sirvan3tr/axon/OpenBCI_ESP32_BASE/OpenBCI_ESP32_BASE.JPG

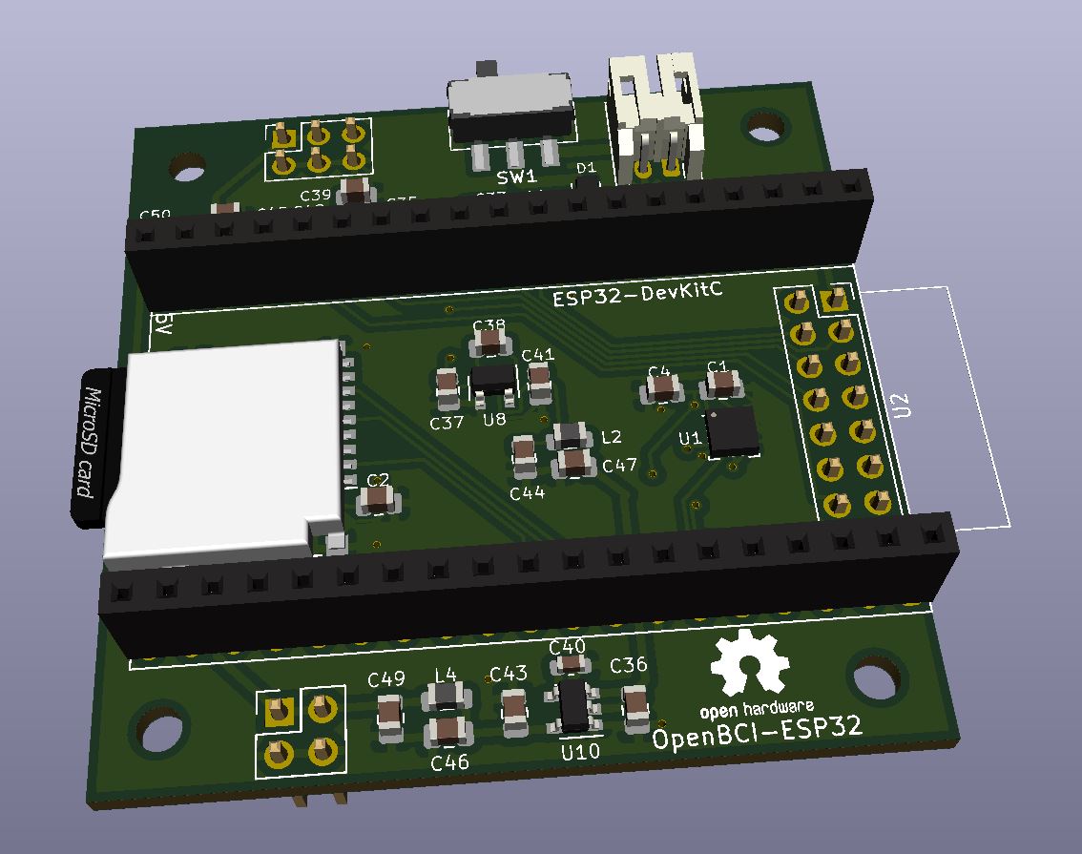
OpenBCI_ESP32_BASE/OpenBCI_ESP32_BASE.JPG
