sirvan3tr/axon/OpenBCI_ESP32_BASE/esp32-devkitc.jpg

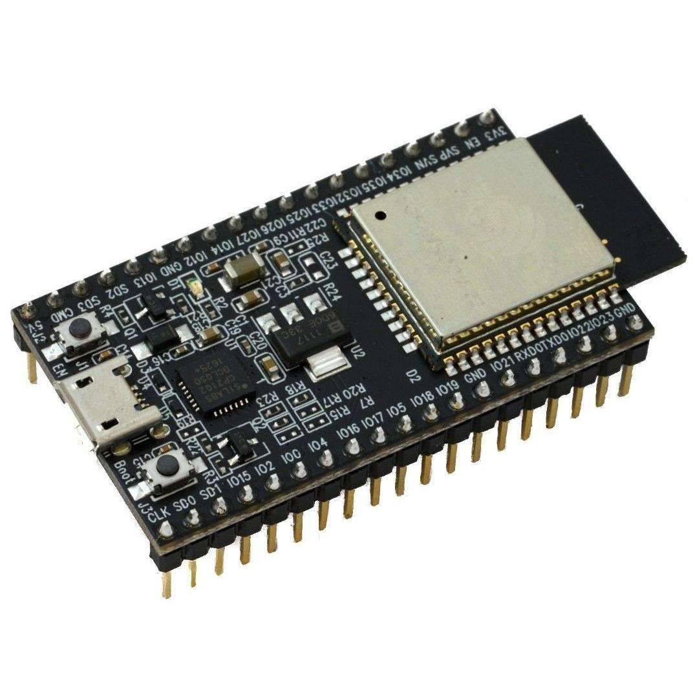
OpenBCI_ESP32_BASE/esp32-devkitc.jpg
