sirvan3tr/axon/README.md

# AXON Firmware

This repo contains the necessary source code to operate the AXON (OpenBCI_ESP32) board.

* **ADS1299**.  This is the 24bit ADC. Has its own independent header file.
* **LIS3DH**.  Accelerator.
* **Board**.  Wrapper class to manage all the other classes.
* **Daisy**.  TBC.
