sirvan3tr/axon/docs.md

# Documentation

* Read the [Arduino Notebook](http://engineering.nyu.edu/gk12/amps-cbri/pdf/ArduinoBooks/Arduino%20Programming%20Notebook.pdf) for more information on types when programming arduino.
* `pinMode()` is an Arduino function. *"Configures the specified pin to behave either as an input or an output. See the Digital Pins page for details on the functionality of the pins."*
* Following [Qt Coding Style](https://wiki.qt.io/Qt_Coding_Style).
* Using [Doxygen](https://www.doxygen.nl/manual/docblocks.html#specialblock) to document the code.
