sirvan3tr/axon/OpenBCI_ESP32_INPUT/OpenBCI_ESP32_INPUT.JPG

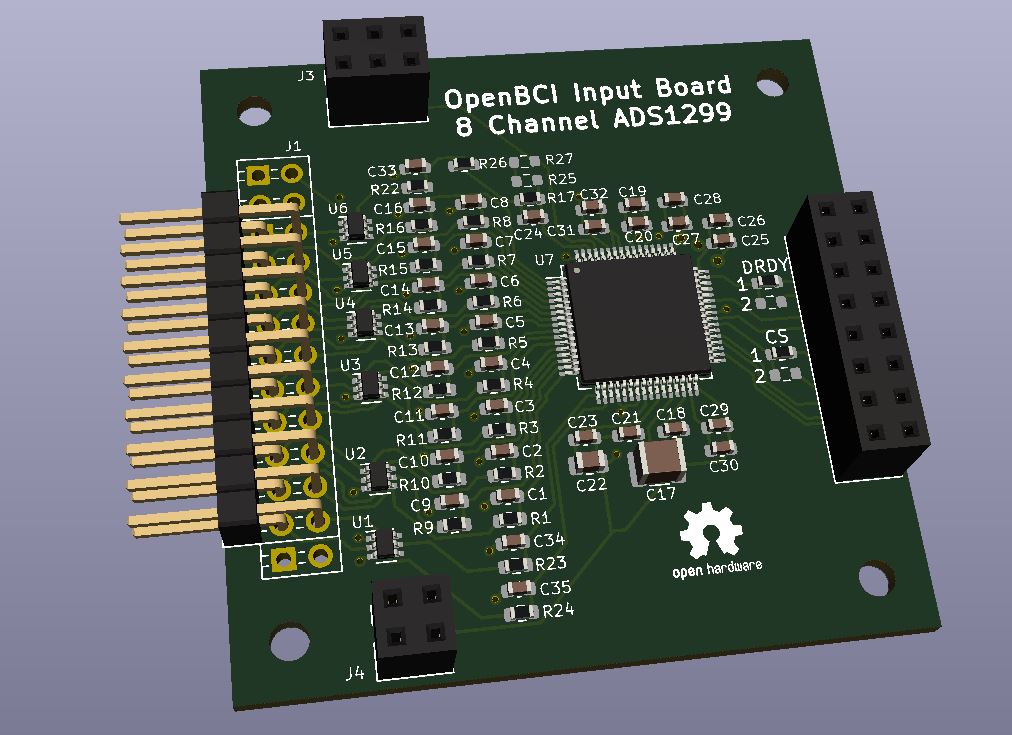
OpenBCI_ESP32_INPUT/OpenBCI_ESP32_INPUT.JPG
