sirvan3tr/axon/Case/Battery.stl

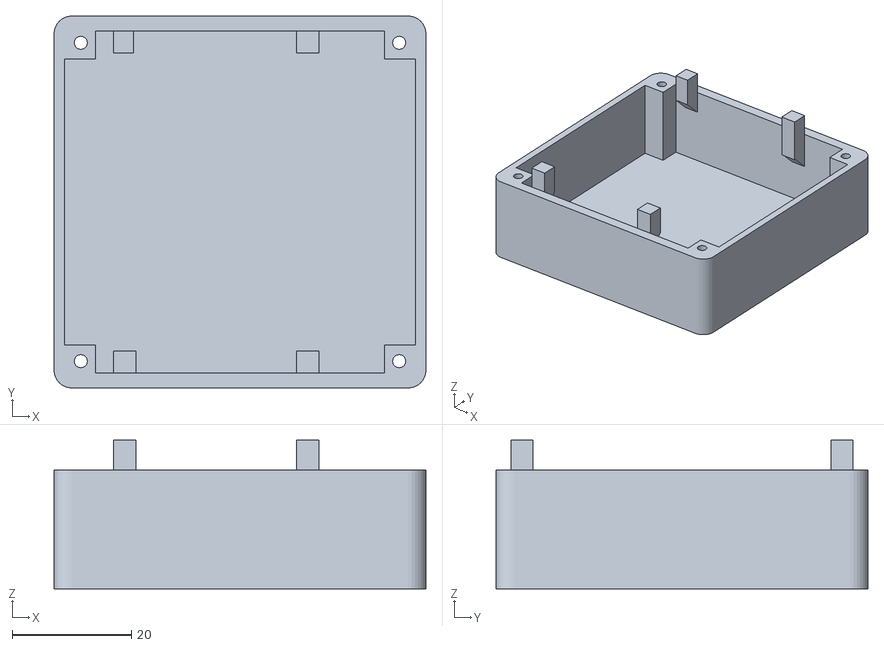
[picture p4: CAD file, 2022-03-14]
Case/Battery.stl
62.5 x 62.5 x 25.0
