sirvan3tr/axon/Case/Switch.stl

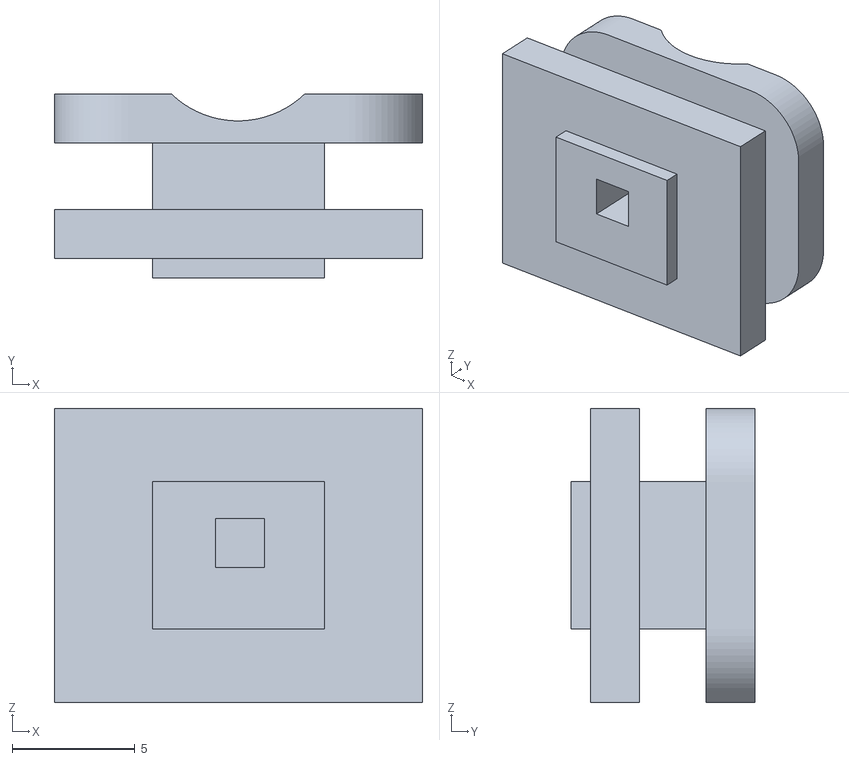
[picture p5: CAD file, 2022-03-14]
Case/Switch.stl
15.0 x 7.50 x 12.0
