sirvan3tr/axon/Case/Input_8.stl

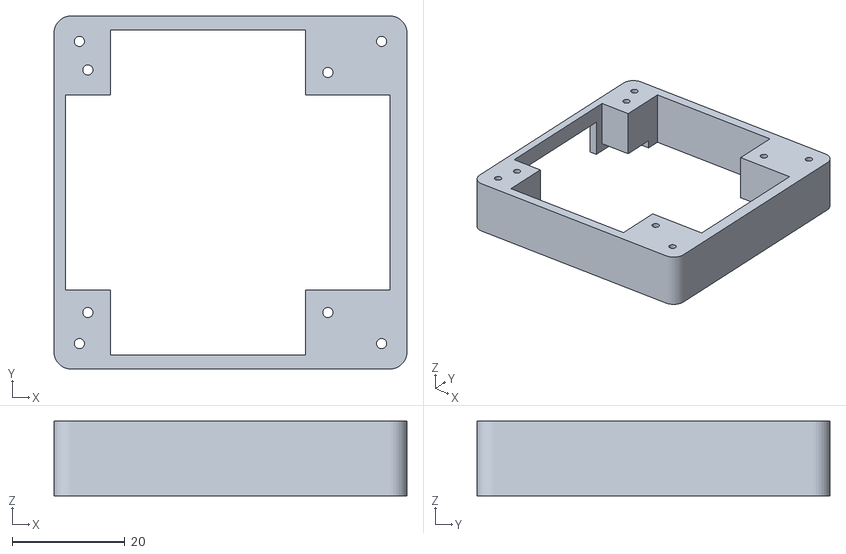
[picture p6: CAD file, 2022-03-14]
Case/Input_8.stl
62.5 x 62.5 x 13.2
