sirvan3tr/axon/Case/Base.stl

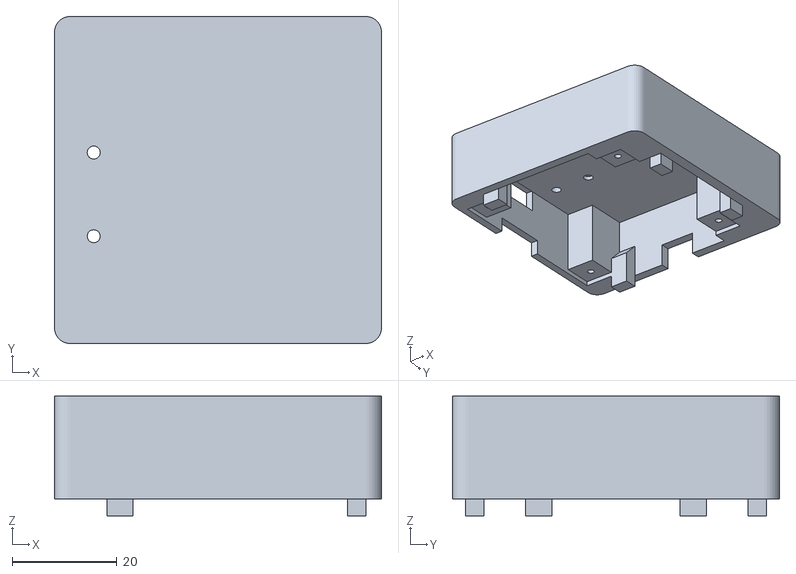
[picture p7: CAD file, 2022-03-14]
Case/Base.stl
62.5 x 62.5 x 22.9
