sirvan3tr/axon/OpenBCI_ESP32_BASE/JS102011SAQN.STEP

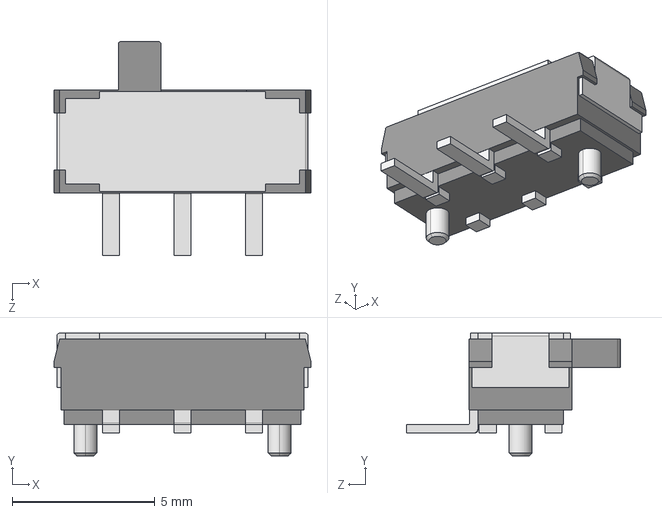
[picture p8: CAD file, 2022-03-14]
OpenBCI_ESP32_BASE/JS102011SAQN.STEP
9.00 x 4.30 x 7.50 mm
