sirvan3tr/axon/(list of files, cad)

Other CAD files:
Case/OpenBCI_ESP v18.f3d
