sirvan3tr/axon/OpenBCI_ESP32_INPUT/OpenBCI_ESP32_INPUT.kicad_pcb

## KiCad design OpenBCI_ESP32_INPUT/OpenBCI_ESP32_INPUT.kicad_pcb (2022-03-14)

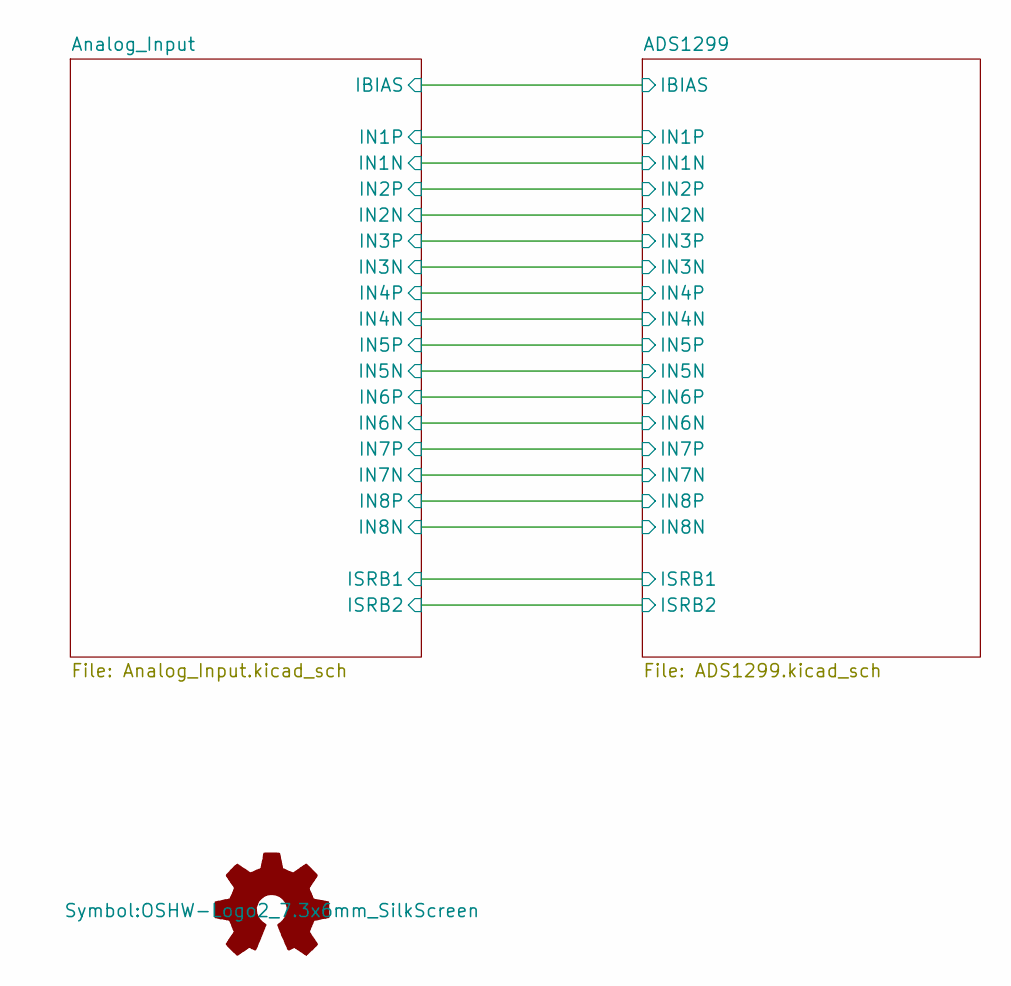
[picture p13: schematic OpenBCI_ESP32_INPUT.kicad_sch]

Parts:
LOGO1: Logo_Open_Hardware_Small; OSHW-Logo2_7.3x6mm_SilkScreen

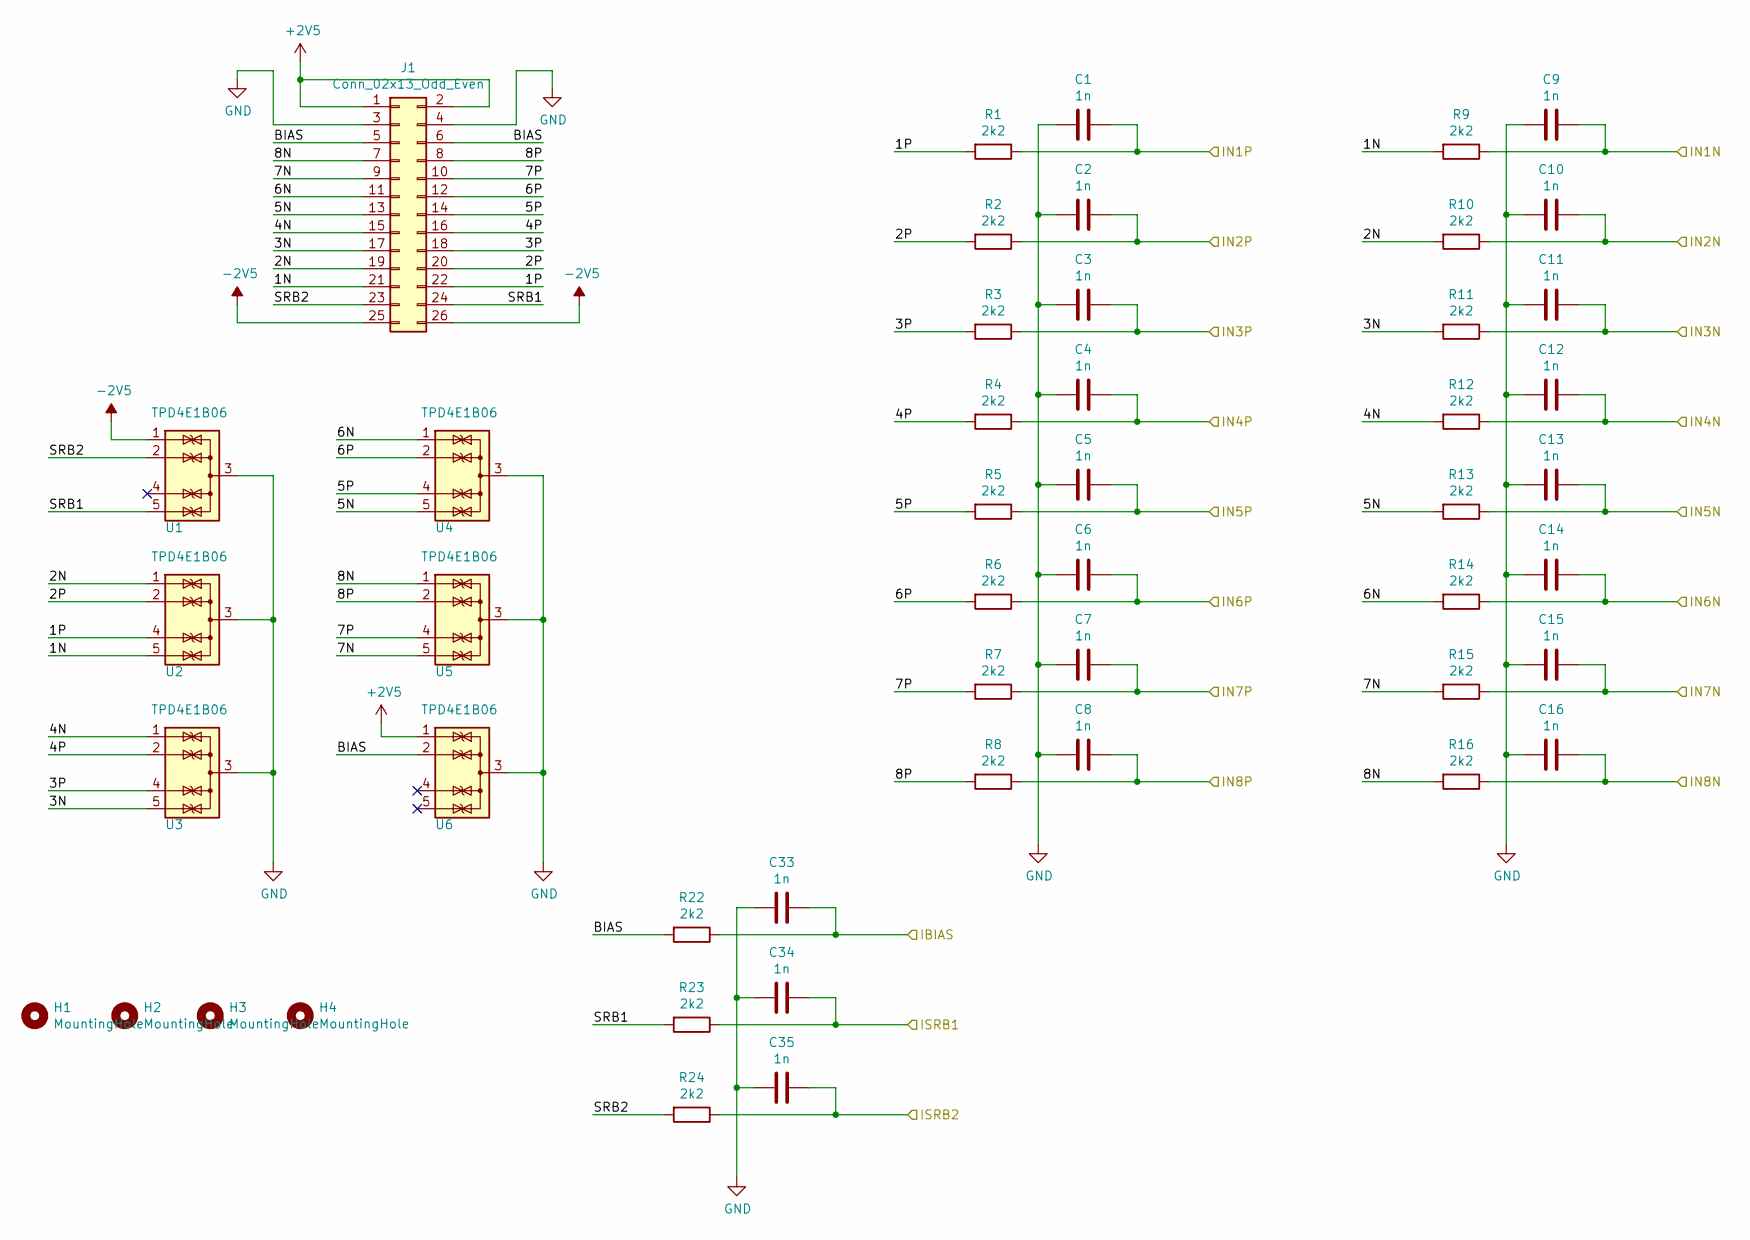
[picture p14: schematic Analog_Input.kicad_sch]

Parts:
C1, C2, C3, C4, C5, C6, C7, C8, C9, C10, C11, C12, C13, C14, C15, C16, C33, C34, C35: 1n; C_0603_1608Metric
H1, H2, H3, H4: MountingHole; MountingHole_2.7mm_M2.5
J1: Conn_02x13_Odd_Even; PinHeader_2x13_P2.54mm_OpenBCI
R1, R2, R3, R4, R5, R6, R7, R8, R9, R10, R11, R12, R13, R14, R15, R16, R22, R23, R24: 2k2; R_0603_1608Metric
U1, U2, U3, U4, U5, U6: TPD4E1B06; SOT-363_SC-70-6

Connections:
+2V5: J1.1, J1.2, U6.1 (IO1); also elsewhere on the board
-2V5: J1.25, J1.26, U1.1 (IO1); also elsewhere on the board
/ADS1299/IBIAS: C33.1, R22.1; also elsewhere on the board
/ADS1299/IN1N: C9.1, R9.1; also elsewhere on the board
/ADS1299/IN1P: C1.1, R1.1; also elsewhere on the board
/ADS1299/IN2N: C10.1, R10.1; also elsewhere on the board
/ADS1299/IN2P: C2.1, R2.1; also elsewhere on the board
/ADS1299/IN3N: C11.1, R11.1; also elsewhere on the board
/ADS1299/IN3P: C3.1, R3.1; also elsewhere on the board
/ADS1299/IN4N: C12.1, R12.1; also elsewhere on the board
/ADS1299/IN4P: C4.1, R4.1; also elsewhere on the board
/ADS1299/IN5N: C13.1, R13.1; also elsewhere on the board
/ADS1299/IN5P: C5.1, R5.1; also elsewhere on the board
/ADS1299/IN6N: C14.1, R14.1; also elsewhere on the board
/ADS1299/IN6P: C6.1, R6.1; also elsewhere on the board
/ADS1299/IN7N: C15.1, R15.1; also elsewhere on the board
/ADS1299/IN7P: C7.1, R7.1; also elsewhere on the board
/ADS1299/IN8N: C16.1, R16.1; also elsewhere on the board
/ADS1299/IN8P: C8.1, R8.1; also elsewhere on the board
/ADS1299/ISRB1: C34.1, R23.1; also elsewhere on the board
/ADS1299/ISRB2: C35.1, R24.1; also elsewhere on the board
/Analog_Input/1N: J1.21, R9.2, U2.5 (IO4)
/Analog_Input/1P: J1.22, R1.2, U2.4 (IO3)
/Analog_Input/2N: J1.19, R10.2, U2.1 (IO1)
/Analog_Input/2P: J1.20, R2.2, U2.2 (IO2)
/Analog_Input/3N: J1.17, R11.2, U3.5 (IO4)
/Analog_Input/3P: J1.18, R3.2, U3.4 (IO3)
/Analog_Input/4N: J1.15, R12.2, U3.1 (IO1)
/Analog_Input/4P: J1.16, R4.2, U3.2 (IO2)
/Analog_Input/5N: J1.13, R13.2, U4.5 (IO4)
/Analog_Input/5P: J1.14, R5.2, U4.4 (IO3)
/Analog_Input/6N: J1.11, R14.2, U4.1 (IO1)
/Analog_Input/6P: J1.12, R6.2, U4.2 (IO2)
/Analog_Input/7N: J1.9, R15.2, U5.5 (IO4)
/Analog_Input/7P: J1.10, R7.2, U5.4 (IO3)
/Analog_Input/8N: J1.7, R16.2, U5.1 (IO1)
/Analog_Input/8P: J1.8, R8.2, U5.2 (IO2)
/Analog_Input/BIAS: J1.5, J1.6, R22.2, U6.2 (IO2)
/Analog_Input/SRB1: J1.24, R23.2, U1.5 (IO4)
/Analog_Input/SRB2: J1.23, R24.2, U1.2 (IO2)
GND: C1.2, C2.2, C3.2, C4.2, C5.2, C6.2, C7.2, C8.2, C9.2, C10.2, C11.2, C12.2, C13.2, C14.2, C15.2, C16.2, C33.2, C34.2, C35.2, J1.3, J1.4, U1.3 (G), U2.3 (G), U3.3 (G), U4.3 (G), U5.3 (G), U6.3 (G); also elsewhere on the board

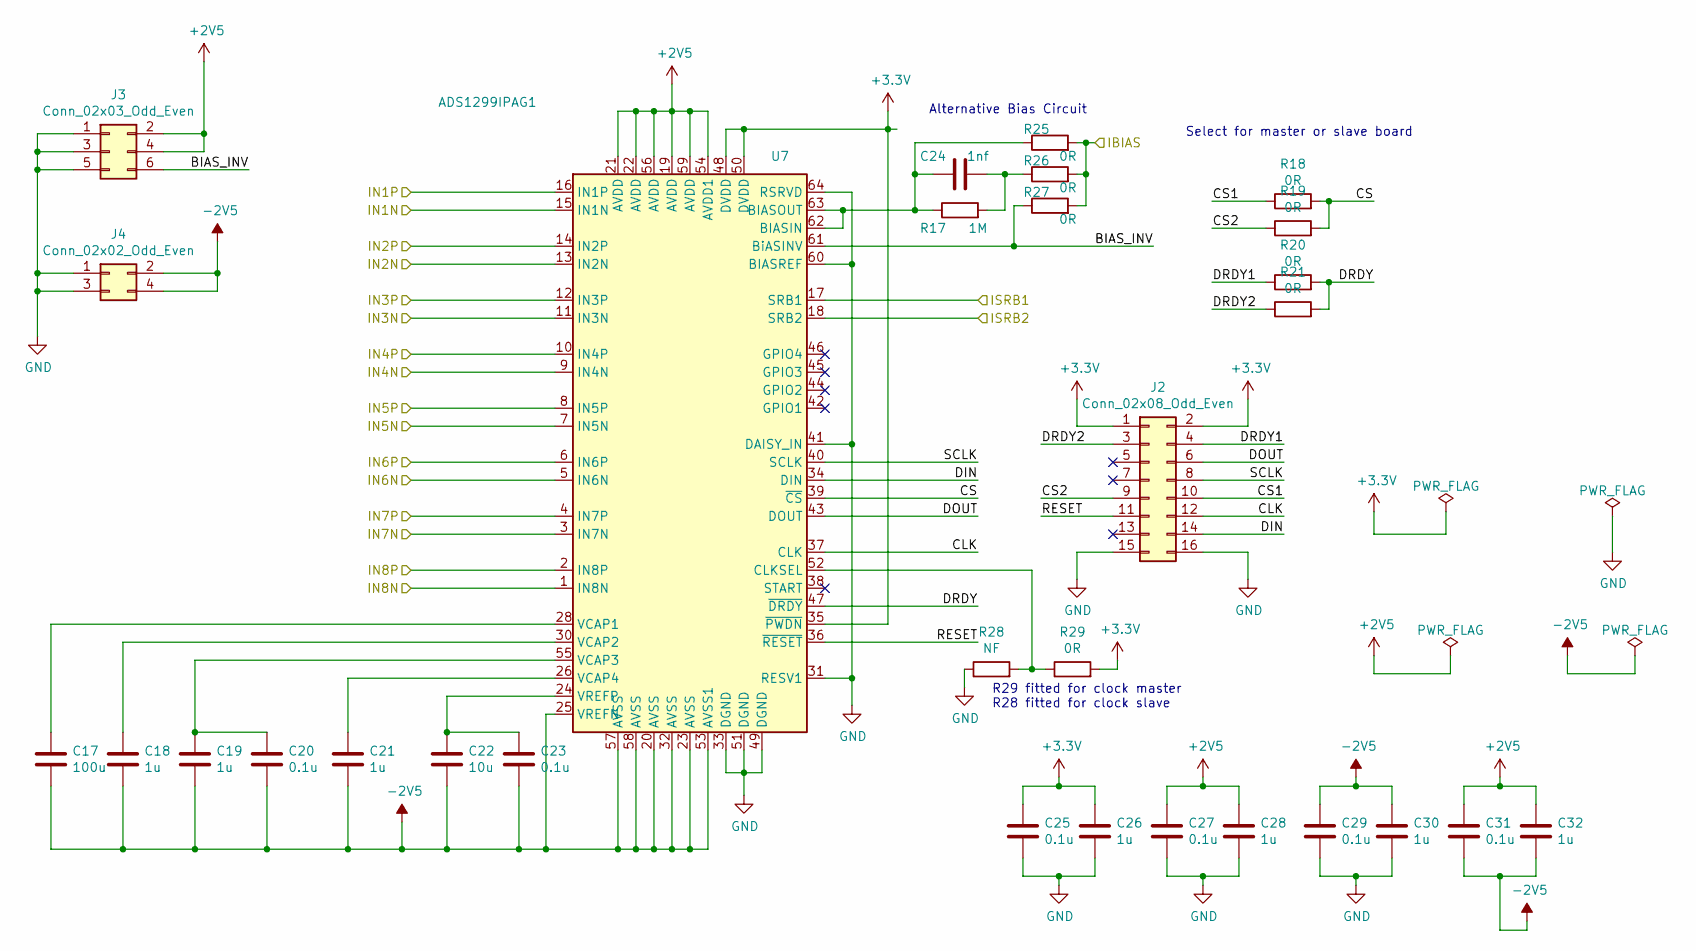
[picture p15: schematic ADS1299.kicad_sch]

Parts:
C17: 100u; C_1210_3225Metric
C18, C19, C21, C26, C28, C30, C32: 1u; C_0603_1608Metric
C20, C23, C25, C27, C29, C31: 0.1u; C_0603_1608Metric
C22: 10u; C_0805_2012Metric
C24: 1nf; C_0603_1608Metric
J2: Conn_02x08_Odd_Even; PinSocket_2x08_P2.54mm_Vertical
J3: Conn_02x03_Odd_Even; PinSocket_2x03_P2.54mm_Vertical
J4: Conn_02x02_Odd_Even; PinSocket_2x02_P2.54mm_Vertical
R17: 1M; R_0603_1608Metric
R18, R19, R20, R21, R25, R26, R27, R29: 0R; R_0603_1608Metric
R28: NF; R_0603_1608Metric
U7: ADS1299IPAG1; TQFP-64_10x10mm_P0.5mm

Connections:
+2V5: C27.1, C28.1, C31.1, C32.1, J3.2, J3.4, U7.19 (AVDD), U7.21 (AVDD), U7.22 (AVDD), U7.54 (AVDD1), U7.56 (AVDD), U7.59 (AVDD); also elsewhere on the board
+3V3: C25.1, C26.1, J2.1, J2.2, R29.2, U7.35 (~PWDN), U7.48 (DVDD), U7.50 (DVDD)
-2V5: C17.2, C18.2, C19.2, C20.2, C21.2, C22.2, C23.2, C29.1, C30.1, C31.2, C32.2, J4.2, J4.4, U7.20 (AVSS), U7.23 (AVSS), U7.25 (VREFN), U7.32 (AVSS), U7.53 (AVSS1), U7.57 (AVSS), U7.58 (AVSS); also elsewhere on the board
/ADS1299/BIAS_INV: J3.6, R27.1, U7.61 (BiASINV)
/ADS1299/CLK: J2.12, U7.37 (CLK)
/ADS1299/CS: R18.2, R19.2, U7.39 (~CS)
/ADS1299/CS1: J2.10, R18.1
/ADS1299/CS2: J2.9, R19.1
/ADS1299/DIN: J2.14, U7.34 (DIN)
/ADS1299/DOUT: J2.6, U7.43 (DOUT)
/ADS1299/DRDY: R20.2, R21.2, U7.47 (~DRDY)
/ADS1299/DRDY1: J2.4, R20.1
/ADS1299/DRDY2: J2.3, R21.1
/ADS1299/IBIAS: R25.2, R26.2, R27.2; also elsewhere on the board
/ADS1299/IN1N: U7.15 (IN1N); also elsewhere on the board
/ADS1299/IN1P: U7.16 (IN1P); also elsewhere on the board
/ADS1299/IN2N: U7.13 (IN2N); also elsewhere on the board
/ADS1299/IN2P: U7.14 (IN2P); also elsewhere on the board
/ADS1299/IN3N: U7.11 (IN3N); also elsewhere on the board
/ADS1299/IN3P: U7.12 (IN3P); also elsewhere on the board
/ADS1299/IN4N: U7.9 (IN4N); also elsewhere on the board
/ADS1299/IN4P: U7.10 (IN4P); also elsewhere on the board
/ADS1299/IN5N: U7.7 (IN5N); also elsewhere on the board
/ADS1299/IN5P: U7.8 (IN5P); also elsewhere on the board
/ADS1299/IN6N: U7.5 (IN6N); also elsewhere on the board
/ADS1299/IN6P: U7.6 (IN6P); also elsewhere on the board
/ADS1299/IN7N: U7.3 (IN7N); also elsewhere on the board
/ADS1299/IN7P: U7.4 (IN7P); also elsewhere on the board
/ADS1299/IN8N: U7.1 (IN8N); also elsewhere on the board
/ADS1299/IN8P: U7.2 (IN8P); also elsewhere on the board
/ADS1299/ISRB1: U7.17 (SRB1); also elsewhere on the board
/ADS1299/ISRB2: U7.18 (SRB2); also elsewhere on the board
/ADS1299/RESET: J2.11, U7.36 (~RESET)
/ADS1299/SCLK: J2.8, U7.40 (SCLK)
/ADS1299/VREF: C22.1, C23.1, U7.24 (VREFP)
GND: C25.2, C26.2, C27.2, C28.2, C29.2, C30.2, J2.15, J2.16, J3.1, J3.3, J3.5, J4.1, J4.3, R28.1, U7.31 (RESV1), U7.33 (DGND), U7.41 (DAISY_IN), U7.49 (DGND), U7.51 (DGND), U7.60 (BIASREF), U7.64 (RSRVD); also elsewhere on the board
unnamed: C17.1, U7.28 (VCAP1)
unnamed: C18.1, U7.30 (VCAP2)
unnamed: C19.1, C20.1, U7.55 (VCAP3)
unnamed: C21.1, U7.26 (VCAP4)
unnamed: C24.1, R17.1, R25.1, U7.62 (BIASIN), U7.63 (BIASOUT)
unnamed: C24.2, R17.2, R26.1
unnamed: R28.2, R29.1, U7.52 (CLKSEL)

Notes on the sheet:
R29 fitted for clock master R28 fitted for clock slave
Select for master or slave board
Alternative Bias Circuit

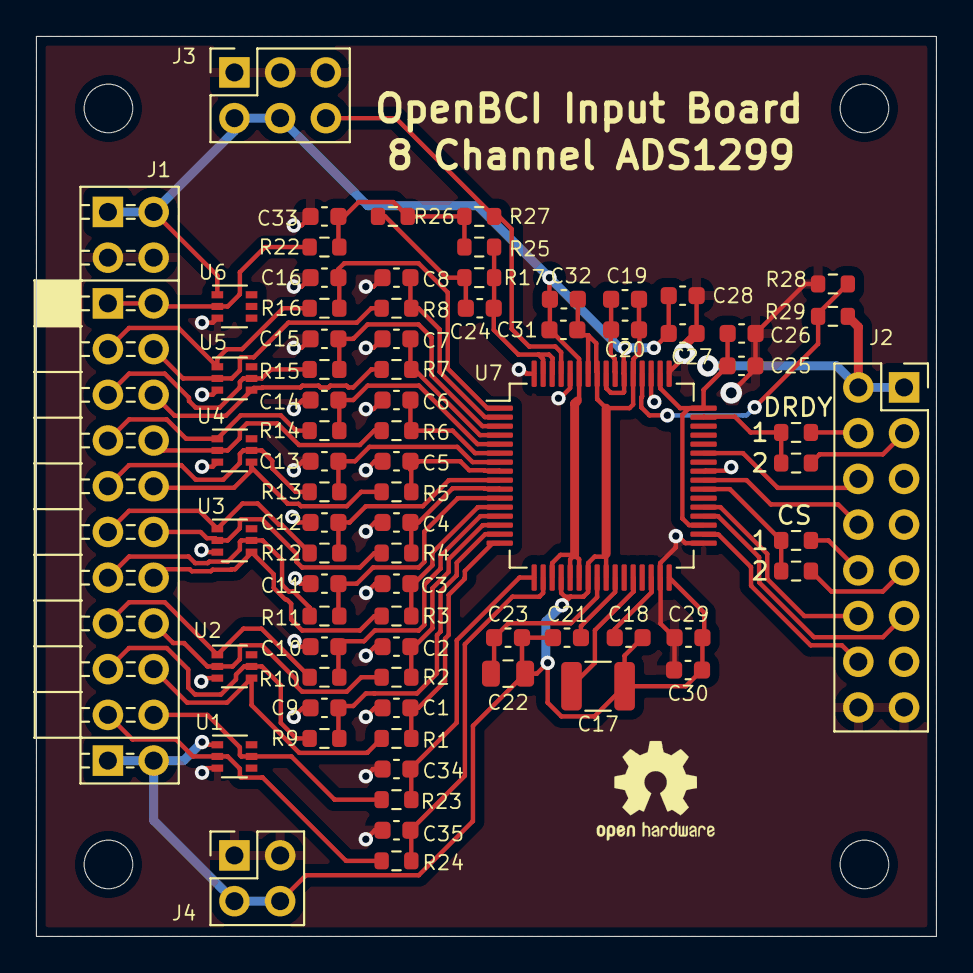
[picture p16: board OpenBCI_ESP32_INPUT.kicad_pcb from above]

Board: 2 copper layers, 50.0 x 50.0 mm, 80 parts (0 on the bottom side), 62 nets.
